bughht/Audio-power-amplifier-circuit/readme.md

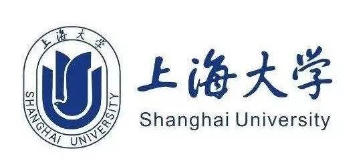
[picture p1: pic/Aspose.Words.00e3c67e-8b58-42eb-a173-c0f91e36cd5e.001.jpeg]

# 音频功率放大器设计

**音频功率放大器技术指标**
   1. 最大不失真输出功率：		Pom≥8W（负载阻抗RL=8Ω）
   1. 输入灵敏度：				Vi≤100mv（输入阻抗R>47kΩ）
   1. 频率响应：					f=20Hz~20kHz
   1. 噪声电压：					VN<15mv（±3dB）
   1. 失真度：					γ≤3%
1. 音调控制范围：		  	100Hz±6dB~10kHz±6dB 

**各单元电路静态工作点**
   
   1. **T1：K30（前置放大电路）**
   
      VDSQ=0.42V
   
      VGSQ=-1.32V
   
      IDQ=0.513mA
   
   2. **T2：K30（前置放大电路）**
   
      VDSQ=10.39V
   
      VGSQ=-1.54V
   
      IDQ=0.001mA
   
   3. **T5:2N5551（差分电路）**
   
      VCEQ=12.12V
   
      ICQ=0.727mA
   
      IBQ=0.004mA
   
   4. **T6:2N5551（差分电路）**
   
      VCEQ=10.86V
   
      ICQ=0.723mA
   
      IBQ=0.004mA
   
   5. **T7:2N5551（差分电路电流源）**
   
      VCEQ=10.51V
   
      ICQ=1.45mA
   
      IBQ=0.012mA
   
   6. **T8:2N5401（推动级电路）**
   
      VCEQ=-10.65V
   
      ICQ=1.33mA
   
   7. **T9:2N5551（**VBE**扩大电路）**
   
      	VCEQ=2.002V
   
   8. **T10:8050（推挽功放）**
   
      VCEQ=11.21V
   
      ICQ=3.59mA
   
   9. **T11:8550（推挽功放）**
   
      VCEQ=11.14V
   
      ICQ=6.33mA
   
   10. **T12：TIP41（推挽功放功率管）**
   
       VCEQ=12V
   
   11. **T13：TIP41（推挽功放功率管）**
   
       VCEQ=12V
   
**前置放大器设计**

   前置放大器因为需要与多信号源匹配，应当具有较高的输入阻抗（R>47kΩ），同时由于前置放大器的输出信号直连音调控制电路，应当具有较低的输出阻抗。此处采用场效应管共源放大电路与源极跟随电路组成前置放大器。

   已知放大器输入电压100mV，输入阻抗Ri>47kΩ，输出阻抗RO<1kΩ，频率响应范围20Hz~50kHz。

   1. **静态工作点选择**
      1) T1：K30

      VDSQ=0.42V

      VGSQ=-1.32V

      IDQ=0.513mA

      1) T2：K30

      VDSQ=10.39V

      VGSQ=-1.54V

      IDQ=0.001mA

   2. **选择RS、RD**

      1. 根据2SK30A场效应管手册查阅的资料，

            

      				Vgsoff=-1.6V  gm=1.8mA/V  IDSS=5.2mA

      				因为Vi<100mV，为减小高频噪音，工作点Q应选择较低点，经测量取VGSQ=-1.32V，则IDQ=IDSS1-VGSQVGSoff2=0.513mA。

      				电源电压为12V，则

      				VDS=0.42V

      				VD=1.74V

      				VS=1.32V

      				RD=E-VDIDQ=20kΩ

      				RS=VSIDQ=2.57kΩ

      				取R2=680Ω，R3取为10kΩ电位器用于调整前置放大增益。

   3. **计算电容**C1**，**C2

      因Ri≈R1，取R1=1MΩ，取fL=20Hz。

      C1≥102πfLR1≈0.8μF

      取C1=1μF。

      C2≥1+gmR22πfLR2≈16μF

      取C2=20μF。

   4. **场效应管源极电压跟随器设计**

      为了得到更大的动态跟随范围，一般将工作点选在转移特性曲线的中点。

      VGS=-1.6V

      取R5=1MΩ，R6=2kΩ。

   5. **测量频率响应**

      测量频率响应时，将电位器W1，W2和W3都设置于最小阻值。输入100mVpp正弦信号，测量不同频率下的前置放大器输出的频率响应，绘制幅频特性曲线。数据详见附录

      

      经测量，前置放大器中频增益为7.6倍（17.6dB），fL=5Hz，fH=1MHz。

   6. **音调控制电路设计**

      电路结构如下：

      

   7. **选用线性电位器**W1=W2=100kΩ**，采用UA741C集成运放。**

   8. **计算元件参数**

      C1=C2=12πW2fL1≈0.021μF≈22nF

      R1=R2=W2fL2fL1-1=21kΩ≈100kΩ

      R3=8.2kΩ

      R4=RafL2fL1-1=3R1fL2fL1-1≈100kΩ

      C3=12πR4fH2≈970pF≈1000pF

**幅频特性分析**

经测量，音调控制电路的幅频特性如下图所示：

其中

1) 蓝线：低频衰减-高频衰减
1) 橙线：低频衰减-高频增强
1) 绿线：低频增强-高频衰减
1) 红线：低频增强-高频增强

数据详见附录，图表使用Python的Matplotlib库绘制。为使线条连贯，使用scipy的interpolate对采样点进行三次插值。输出结果如下：



经测试，转折频率：

fL1=20Hz;  fL2=100Hz

fH1=1kHz;  fH2=10kHz

增益：

低音最大提升量=5.49dB

高音最大提升量=11.05dB

低音最大衰减量=-5.91dB

高音最大衰减量=-6.33dB

**OCL放大器设计**

电路结构如图所示：



**确定电源电压**

Ec=1η2PomRL≈12V

**推挽输出功率管选择**

要求VCEOM>2Ec=24V;ICM>EcRL≈1.5A;PCM>0.2Pom+EcI0≈1.84W

选择采用TIP41大功率NPN三极管，极限参数如下，符合设计所需要求。



**选择T10，T11与电阻**

要求VCEOM>2EC=24V; ICM>1.5IC12Mβ12≈40mW，选择8050与8550作为T10与T11。

根据R31=R32=(0.05~0.1)RL，R31=R32=0.5Ω，使用高功率电阻。

R27=R30=5ril2=202.5Ω，取R27=R30=220Ω

取R34=R27//ril2≈34Ω≈30Ω。

**最大输出功率测量**

POM=8.24W

**系统电路的工作效率**

电源功率：PE=VCC⋅ICC=2π⋅VCCVOMRL=10.96W

η=π4⋅VOMVCC=0.75=75% 

**产品评估**

本项目设计是一款音频功率放大器，用于对低功率的音频小信号进行功率放大，输出至音响、扬声器等大功率驱动设备。音频功放的应用场景极为广泛，从耳机到车载音响再到影院级别商用场景，而本设计下的音频功放最大输出功率为约8W，所适应的应用场景为家庭立体声以及车载音响等中近距离扬声器设备。

本项目在电路上由三部分组成：前置放大电路，音调控制电路和OCL功率放大电路。

本音频功放电路作为具有一定实验性质的硬件设计，在实现产品化与商业价值之前需提高其附加价值，除对电路板的功能进行进一步完善之外，还需要进行以下设计。

首先是确定应用场景，此处我们将其应用于手持式扩音器设备，用于提高发言人的音量，以便使更大范围的人可以收听到发言。手持扩音器是一种易于携带且结构简单的音频增强设备，结构主要由麦克风（输入），功放电路（放大），扩音喇叭（输出），按键控制电路（控制）以及外壳组成。由于目前完成设计的仅为音频功放电路，要实现手持扩音器需要对其进一步完善，步骤如下：

1. 修改功放电路，使用表面贴装器件（SMD）替代直插元器件，减小电路体积。
1. 设计音频输入电路，加装麦克风收录外界声音信号并转化为电信号。
1. 选择功率匹配的输出音响，用于输出功率放大后的音频信号
1. 设计按键控制电路，同时改良功放电路中的音调控制模块，使用按键控制开关以及音调
1. 设计电源模块，用于便携供电
1. 设计手持扩音器外壳与图文装饰

预算角度来看，本产品需要电路硬件工程师对现有的功放电路进行改良优化，需要设计外壳与图文，由于目标将其升级为单个产品而非企业批量生产设备，外壳生产采用SLA光固化技术进行3D打印，避免熔融沉积固化中常见的表面层纹问题，也降低支架拆卸时损坏模型的风险。电路设计改良预算200元，电路加工PCB打样SMD贴片总计预算100元，外壳设计及图文设计预算200元，外壳生产（采用SLA）与图文加工总计120元，再加上人工管理花费成本总计约1000元。

在使用过程中容易出现故障的主要是音响的输出模块和功放电路。其中音响的输出扬声器容易受环境温度与湿度影响。参考JBL HDI系列扬声器使用手册，音响的正常工作温度范围为为-10℃~40℃，若超出此温度范围，扬声器的输出音效可能会有所影响。考虑到实验板上功放的功率管上存在一定的电流热效应，因此在改良电路设计的过程中应当考虑到散热问题。

湿度也会影响扬声器的输出效果。考虑到手持式扩音器常应用于室外环境，因此扬声器作为输出单元极为容易受潮，因此在选择扬声器的时候应当考虑聚合物材料而非纸盆类扬声器，同时设计外壳时也应当考虑到防潮问题，在接缝处设计橡胶垫避免水汽进入，音响功放与扬声器的正常运作。

1. **数据附录**
   1. **输入级频率响应**

|**f(Hz)**|**Av(dB)**|
| -: | -: |
|1|3.167250|
|2|9.657472|
|3|12.709675|
|4|14.048611|
|5|14.963761|
|8|15.903692|
|10|16.231500|
|20|16.650178|
|50|16.751769|
|100|16.751769|
|200|16.751769|
|300|16.751769|
|500|16.751769|
|1000|16.751769|
|2000|16.751769|
|5000|16.751769|
|10000|16.751769|
|20000|16.751769|
|50000|16.751769|
|100000|16.751769|
|200000|16.751769|
|300000|16.547385|
|500000|16.338077|
|600000|16.014342|
|700000|15.791614|
|800000|15.563025|
|900000|15.086967|
|1000000|14.838782|
|1500000|12.381867|
|2000000|9.883092|

1. **音调控制电路增益**

|**f(Hz)**|**Low-Low**|**Low-High**|**High-Low**|**High-High**|
| -: | -: | -: | -: | -: |
|10.0|-5.704715|-5.500331|5.352125|5.495696|
|20.0|-5.421335|-5.230429|5.179811|5.460025|
|50.0|-4.286783|-3.882715|4.177675|4.638982|
|100.0|-3.126944|-2.532118|2.523988|2.893656|
|200.0|-1.788008|-1.004351|0.394881|1.310031|
|500.0|-0.594372|0.432252|-0.594372|0.432252|
|1000.0|-1.563472|1.166541|-1.563472|1.446828|
|2000.0|-3.324385|3.442551|-3.324385|3.385028|
|5000.0|-5.588348|6.886292|-5.365584|6.937688|
|10000.0|-6.334685|9.495090|-6.334685|9.548378|
|15000.0|-6.334685|10.810333|-6.334685|10.810333|
|20000.0|-6.334685|11.055102|-6.334685|10.999649|
