bughht/Audio-power-amplifier-circuit/(list of files, drawings)

Other design files:
电路.ms14
音调控制.ms14
